jasonful/esp32cam-car/front.jpg

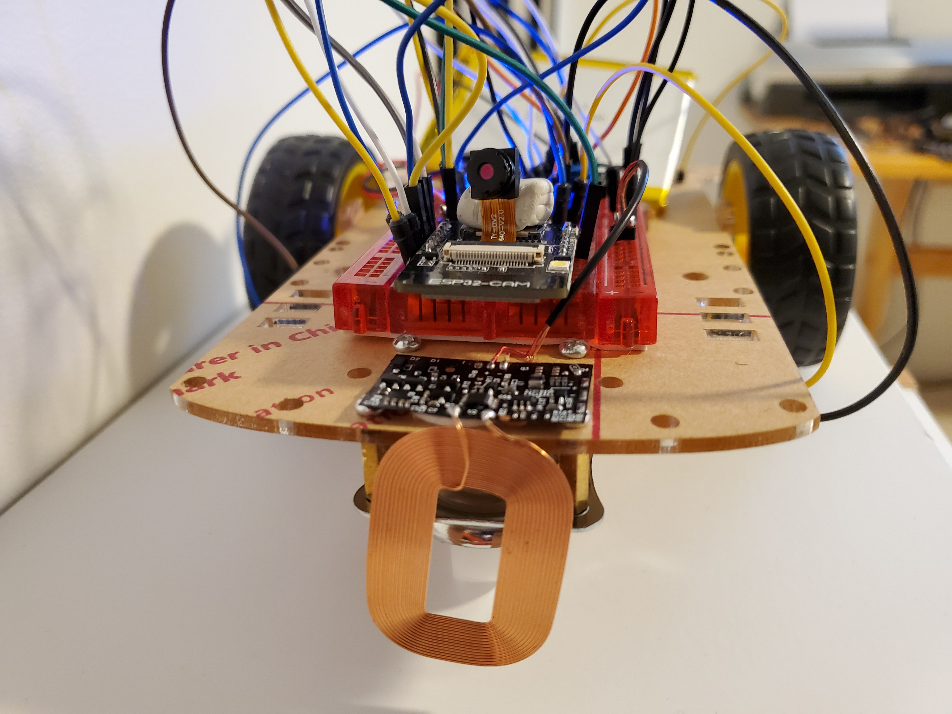
front.jpg
