jasonful/esp32cam-car/antenna.jpg

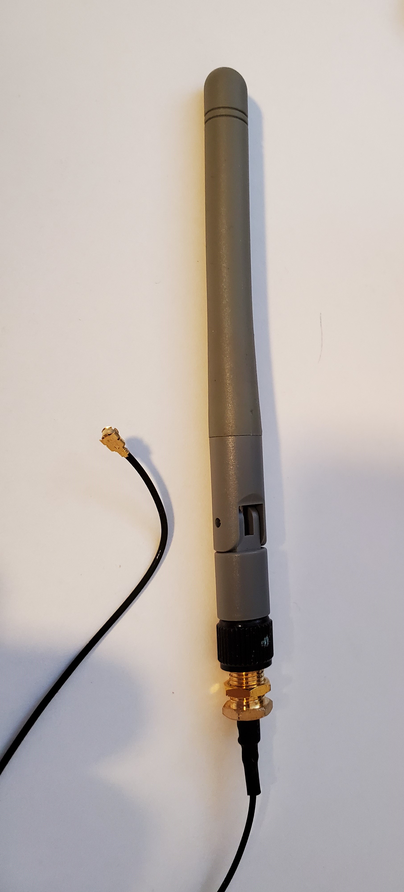
antenna.jpg
