jasonful/esp32cam-car/charger.jpg

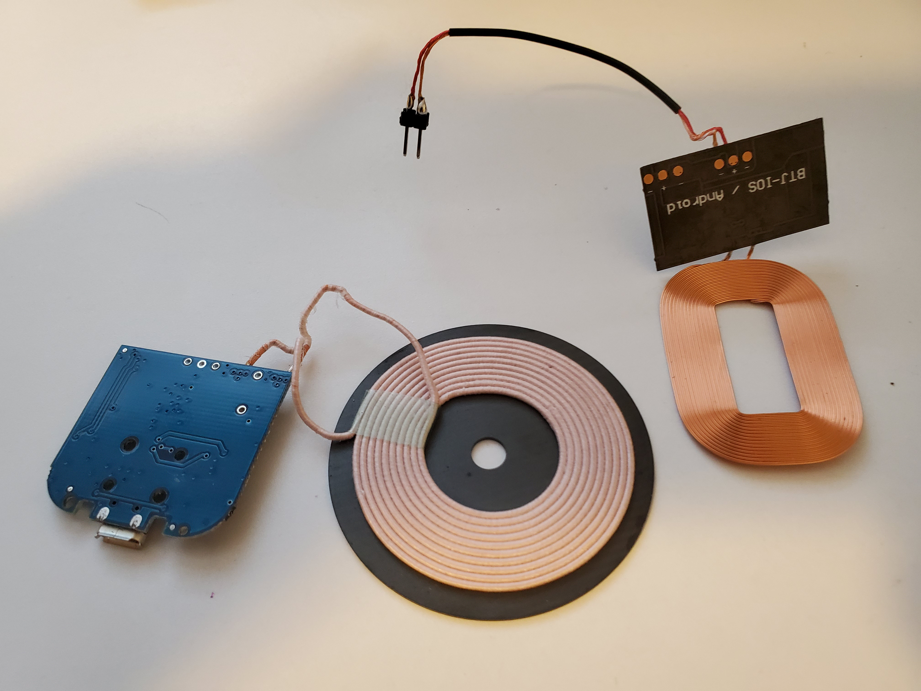
charger.jpg
