jasonful/esp32cam-car/side.jpg

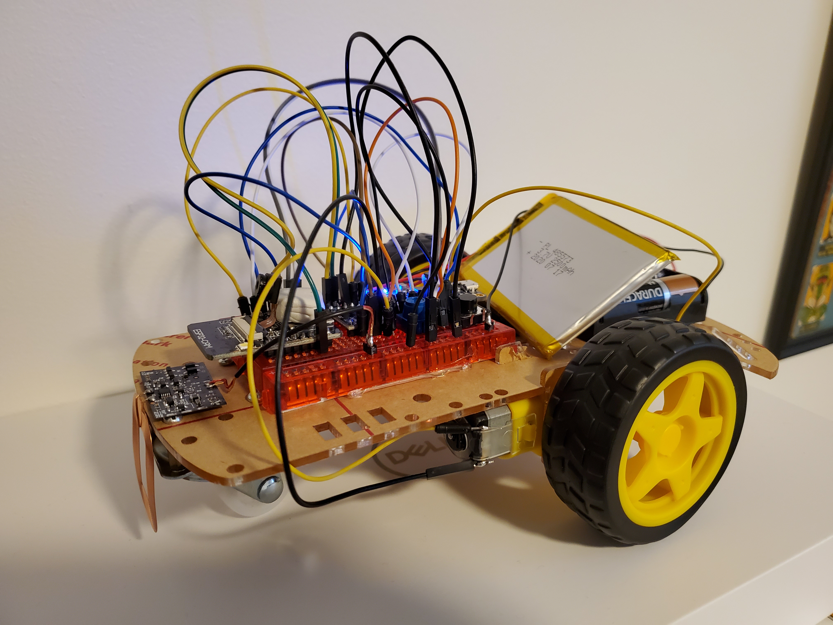
side.jpg
