jasonful/esp32cam-car/wiring.png

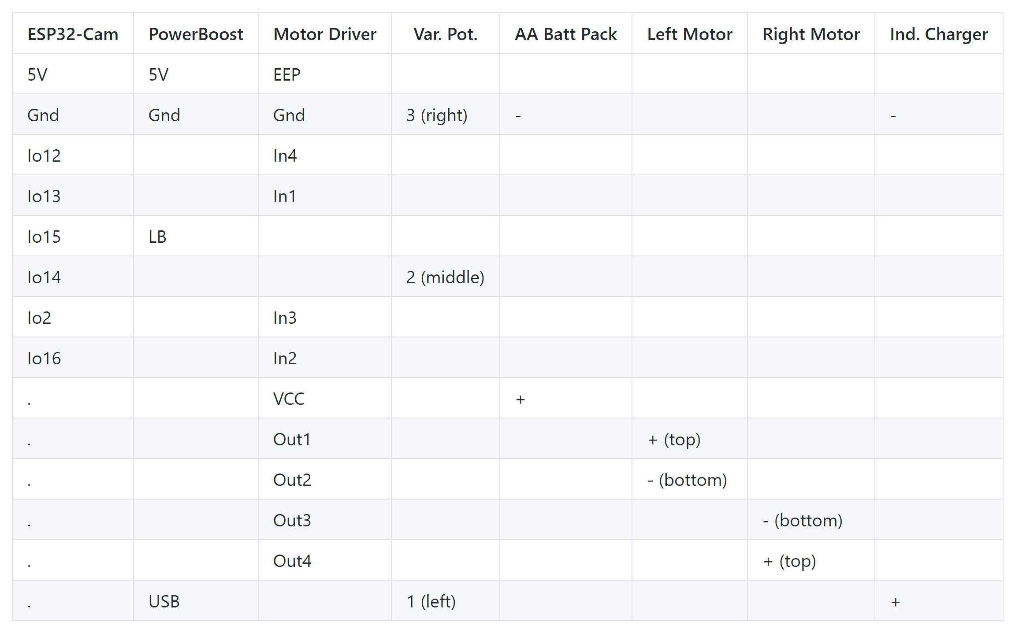
wiring.png
