jasonful/esp32cam-car/(commit log)

2021-01-05 Initial checkin
    [wiring.xlsx]
2021-01-05 wiring image
2021-02-12 update wiring.png io14->io16
