jasonful/esp32cam-car/dock.jpg

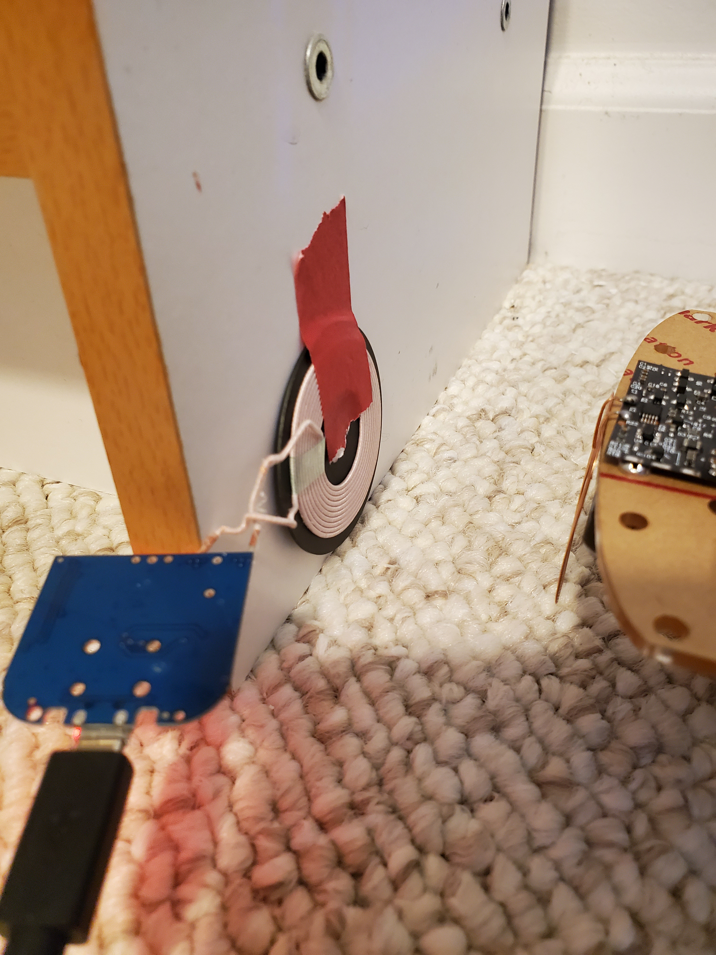
dock.jpg
