jasonful/esp32cam-car/top.jpg

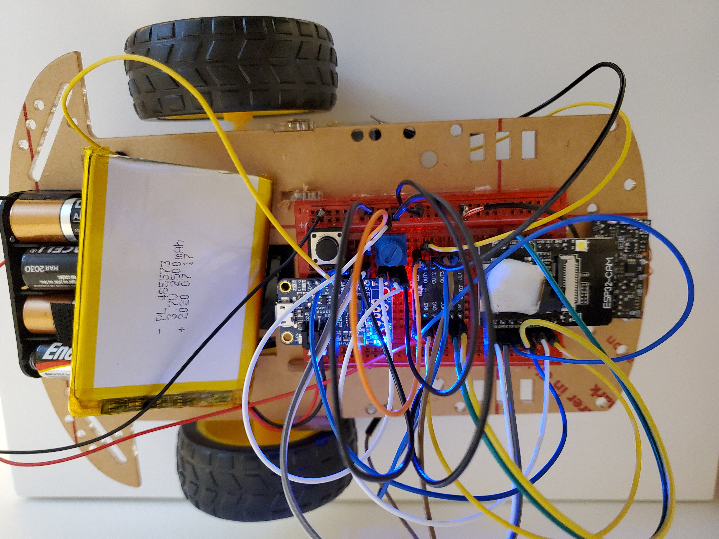
top.jpg
