jasonful/esp32cam-car/motor.jpg

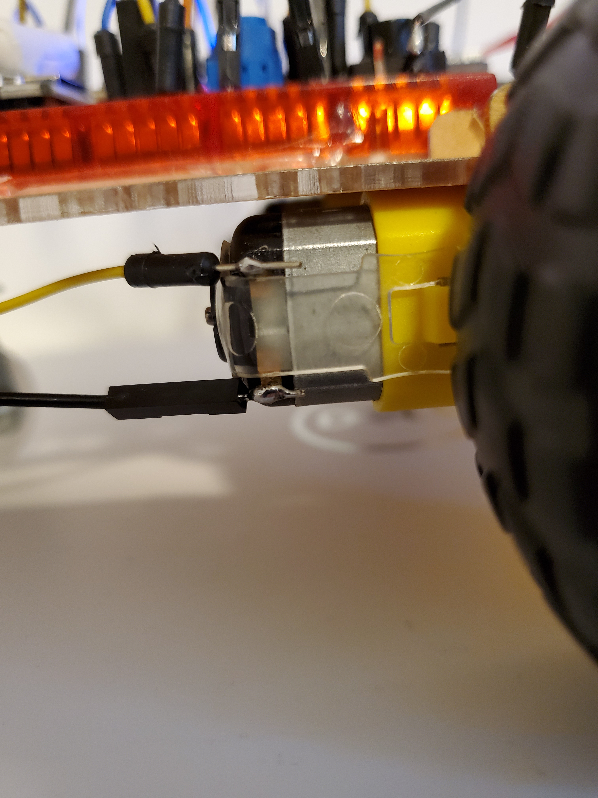
motor.jpg
